matiasAguirreE/project-sumobot/README.md

# Universidad de Chile SumoBot Project

## Table of Contents

1. [Introduction](#introduction)
2. [Features](#features)
3. [Requirements and getting started](#requirements-and-getting-started)
4. [Contributing](#contributing)
5. [Team Members](#team-members)
6. [License](#license)
7. [Acknowledgments](#acknowledgments)

## Introduction

Welcome to the Universidad de Chile SumoBot Project! This repository contains the design, code and documentation for a competitive sumo robot built by a team of engineering students at the Universidad de Chile. The goal of this project is to create a powerful and agile sumobot capable of competing in local sumo robot competitions.

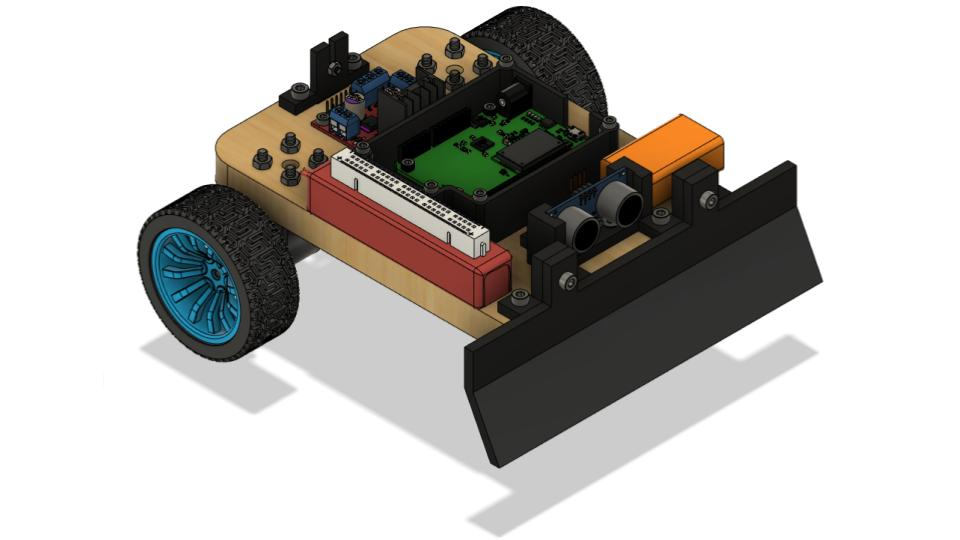
[picture p1: docs/media/sumobot.jpg]
Sumobot (https://www.youtube.com/watch?v=oi4M8AJG_24)


## Features

- Built-in object detection and tracking using sensors
- Modular design for easy hardware and software upgrades
- Comprehensive documentation for building and programming the sumobot

## Requirements and getting started

For the requirements and instructions to build and use this robot, please refer to the [assembly instructions](https://github.com/matiasAguirreE/project-sumobot/blob/main/docs/assembly-instructions) on this repository.

## Contributing

We welcome contributions from the community! If you'd like to contribute to the Universidad de Chile SumoBot Project, please follow these steps:

1. Fork this repository.
2. Create a new branch with a descriptive name.
3. Make your changes and commit them to your branch.
4. Open a pull request describing your changes and why they should be incorporated into the project.
5. The maintainers will review your pull request and provide feedback or merge it.

## Team Members

- [Matías Aguirre Erazo](https://github.com/matiasAguirreE)
- [Juan Francisco Salvo](https://github.com/Juan-salvo)
- [Vicente Valdés](https://github.com/vicentevaldes)

## License

This project is licensed under the Creative Commons Attribution 4.0 International License - see the [LICENSE](https://creativecommons.org/licenses/by/4.0/) file for details.

## Acknowledgments

We would like to thank the Universidad de Chile and our professors for their guidance and support throughout this project. We also appreciate the open-source community.
