matiasAguirreE/project-sumobot/docs/hardware-list/README.md

# Hardware Requirements

The following components are required to build the Universidad de Chile SumoBot:

## [Gearmotor with Wheel](https://hubot.cl/producto/motoreductor-con-rueda-y-soporte-188rpm-12v-sku-87a1/)

Gearmotor with Wheel
Component Dimensions
Support Dimensions
Wheel Dimensions

### Technical specifications:

- Operating voltage: 6 to 18V
- Rated voltage: 12V
- Speed: 188rpm
- Speed with load: 131 rpm
- No-load current: 50mA
- Maximum current with load: 1200 mA
- Cutback: 1:45
- Torque: 5 Kg x cm
- Engine Weight: 86 gr
- M4 nut, grub screw, M3x10 screws and nuts and a wheel included

## [Battery](https://articulo.mercadolibre.cl/MLC-464519432-bateria-lipo-111v-25c-1300mah-airsoft-replicas-paintball-_JM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)

Battery

### Technical specifications:

- Li-poly battery
- 11.1v 25c 1300mAh
- Airsoft replicas
- zoppower brand
- measures 10 cm x 2 cm x 2 cm

## [Driver](https://altronics.cl/modulo-puente-h-l298)

Driver

### Technical specifications:

- Based on the 298 chip.
- Capable of controlling 2 (3-30VDC) Motors
- Supports 3.3V and 5V control.
- Capable of controlling the speed and direction of 2 DC motors.
- Able to control the speed and direction of a stepper motor.
- 2A maximum current per H-bridge.
- Logic voltage levels 4.5 to 5.5V (High) / 0V (Low).
- Maximum consumption power: 20W.

## [Infrared Sensor](https://www.electroardu.cl/sensor-infrarrojo-evasor-de-obstaculos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)

Infrared Sensor

### Technical specifications:

- Operating voltage between 3.3V and 5V
- Detection distance: 2cm-30cm
- Detection angle: 35°

## [Ultrasonic Sensor](https://mcielectronics.cl/shop/product/sensor-de-proximidad-de-ultrasonido-hc-sr04-23582/)

Ultrasonic Sensor

### Technical specifications:

- Operating voltage: 5v DC
- Operating current: 15mA
- Measuring angle: 15°
- Distance range: 2cm – 4m

## [Arduino Uno Board](https://afel.cl/producto/placa-uno-compatible-con-arduino-cable-usb/)

Arduino

### Technical specifications:

- Atmega328P Microcontroller (SMD)
- Input voltage: 7 to 12V
- CH340 USB Microcontroller
- 14 digital I/O pins (6 PWM outputs)
- 6 analog inputs
- 32k flash memory
- 16MHz clock speed

## [Omnidirectional wheel](https://altronics.cl/rueda-omnidireccional)

Wheel Omnidirectional

### Technical specifications:

- Wheel diameter: 24mm
- Base dimensions: 32 x 37mm
- Overall Height: 35mm
- Weight: 31g

## [Jumper wires](https://altronics.cl/jumper-dupont-20cm-mm?search=macho%20macho%20cables)

Cables

### Technical specifications:

- Male-male and male-female needed

## [Protoboard](https://altronics.cl/protoboard-400ptos)

Protoboard

### Technical specifications:

- 400 points
- Dimensions: 8.5 x 5.5 x 0.9cm
- Net weight: 40g

## [Button](https://createc3d.com/es/mas-componentes/797-pulsador-de-boton-6-x-6-x-5-mm.html)

Button

### Technical specifications:

- Contact Type: Momentary
- Plastic cover material
- Material conductive metal electrical parts
- Pins: 4
- Dimensions: 0.6 x 0.6cm
- Weight: 0.8 gr

## [Connector](https://afel.cl/producto/set-conector-xt60-macho-hembra-con-cable-10cm/)

Conector

### Technical specifications:

- Type: XT60 male/female set
- Wire length: 10 cm on both sides

## [9V battery with a DC adapter cable](https://protosupplies.com/product/9v-battery-to-dc-plug-adapter-cable/)

Conector

Additionally, you'll need the following screws and nuts:

| Item | Thread x length | Quantity | What for? |
|:----|:----|:----|:----|
|Socket head screw|M4x25|16| Motors, infrared sensors and weapon supports|
|Flat head screw|M4x25|2| Ultrasonic sensor support|
|Socket head screw|M4x15|2| Weapon |
|Socket head screw|M4x30|4| Omnidirectional wheel |
|Socket head screw|M4x12|2| Back wheels |
|Socket head screw|M3x50|5| Arduino box|
|Socket head screw|M3x10|4| Arduino|
|Socket head screw|M3x25|4| Driver|
|Hex nut|M4|24| All M4 screws |
|Hex nut|M3|9|All M3 screws (except the ones for the Arduino)|

You might also need at least 4 additional M4 hex nuts, please refer to the [assembly instructions](https://github.com/matiasAguirreE/project-sumobot/blob/main/docs/assembly-instructions) for more information.
