matiasAguirreE/project-sumobot/(commit log)

2023-07-03 Update and rename docs/assemblyInstructions.md to docs/assembly-instrucctions/README.md
2023-07-06 DOC: Added button to hardware list
2023-07-10 FEAT: Added feat of the button to attack five seconds after the button was pressed
2023-07-11 FEAT: Added number of pins of motors
2023-07-11 FEAT: Added movement of the motors (but in general, not for particular cases)
2023-07-11 FEAT: Implemented functions of infrared sensors
2023-07-11 FIX: Fixed bug of step, our motors doesn't have steps
2023-07-11 FIX: Fixed bug of button when it was pressed
2023-07-11 BUILD: Created directory to execute the code on Arduino IDE
2023-07-11 FIX: Fixed bug of motors
2023-07-11 FIX: Changed the orientation of the motors
2023-07-11 FIX: Fixed bug of button
2023-07-12 Fixed findEnemy() turn orientation and tweaked maxDistance
    [sumobot_millis.ino]
2023-07-19 Added the conector for the battery
2023-07-19 Added technical specs to the connector
2023-07-20 Added fixture table and battery
2023-07-20 Added motor accesories
2023-07-20 Added folder with assembly steps
2023-07-20 DOCS: added details and images for assembly
2023-07-20 MISC: finished the assembly instructions and deleted redundant .ino file
2023-07-20 DOCS: finished assembly instructions for real this time
2023-07-20 INFO: added specs for the IR sensor and other minor corrections
2023-07-20 TEXT: added quantity of 3D printed parts
